UniversalScientificTechnologies/MRAKOMER3/mrakomer3_Small.jpg

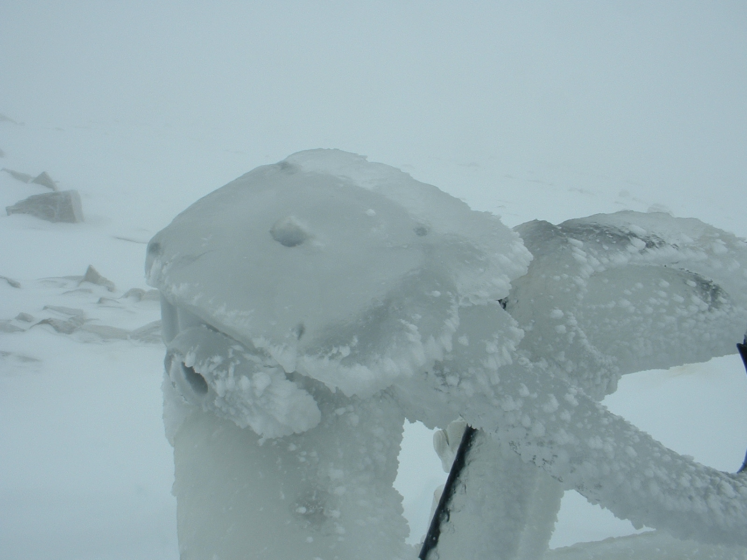
mrakomer3_Small.jpg
