UniversalScientificTechnologies/MRAKOMER3/PrjInfo.txt

//
// This is a project description file.
//

[InfoShortDescription.en]
Mrakomer3 (Clouds sensor) 

[InfoShortDescription.cs]
Mrakoměr3
  
[InfoLongDescription.en]
New design of the Cloudsmeter. This is a device for measurement the clouds coverage. This device is especially constructed for protection of robotics telescopes against rain and snow.

[InfoLongDescription.cs]
Přístroj pro detekci oblačnosti. Byl navržen pro detekci možnosti srážek jako součást robotických dalekohledů. Tento model je první generací bez pohyblivých částí.

[End]
