UniversalScientificTechnologies/MRAKOMER3/DOC/src/P1010130.JPG

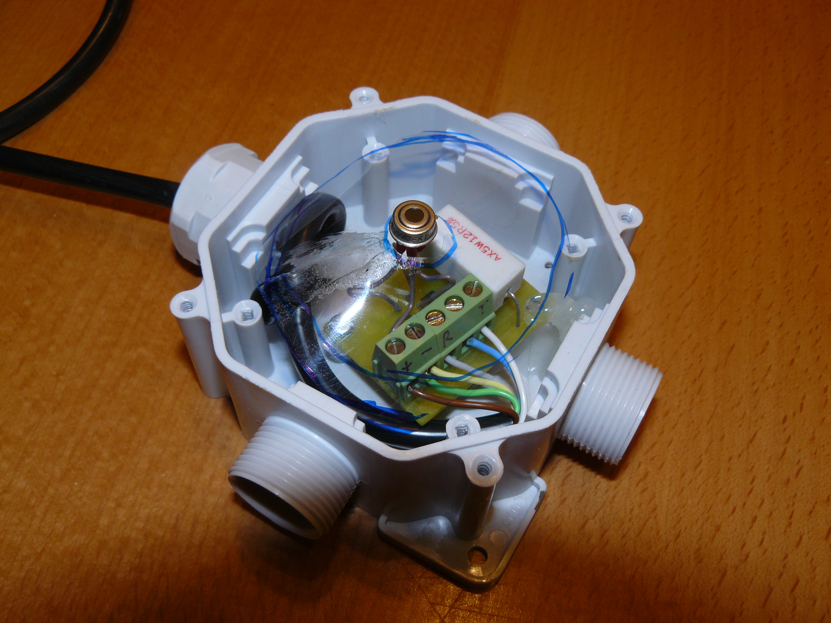
DOC/src/P1010130.JPG
