UniversalScientificTechnologies/MRAKOMER3/DOC/src/P1010132.JPG

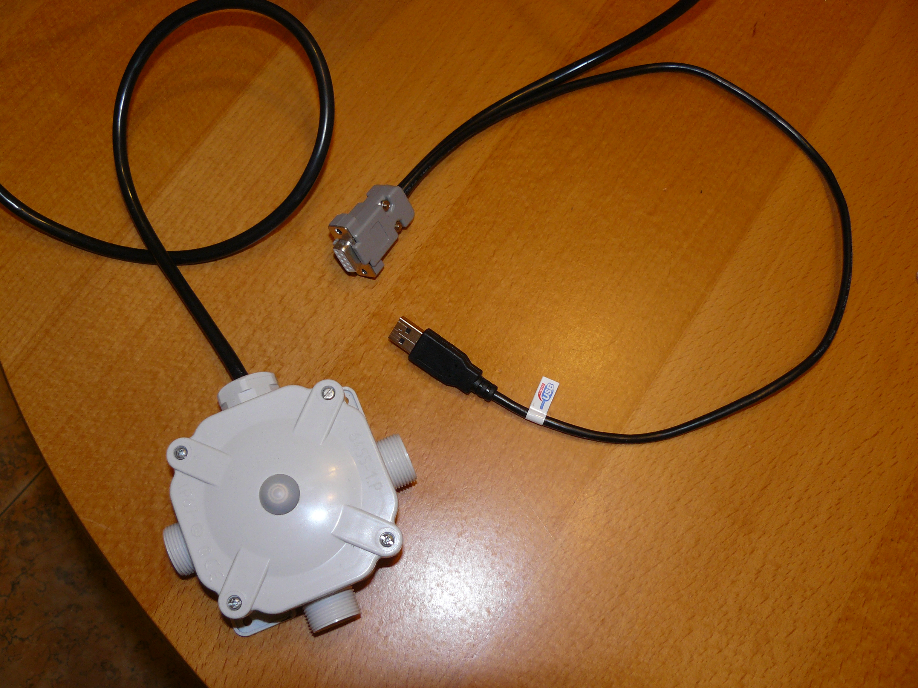
DOC/src/P1010132.JPG
