UniversalScientificTechnologies/MRAKOMER3/CAM/souhrn.pdf

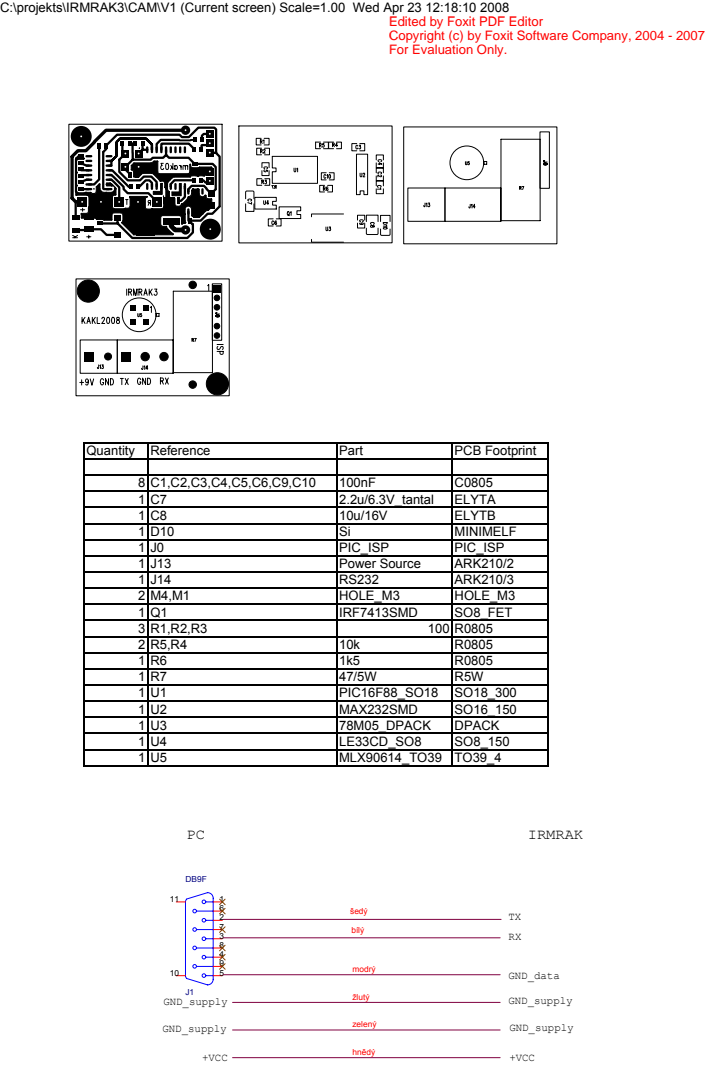
[picture p5: page 1]

C:\projekts\IRMRAK3\CAM\V1 (Current screen) Scale=1.00 Wed Apr 23 12:18:10 2008

Edited by Foxit PDF Editor
Copyright (c) by Foxit Software Company, 2004 - 2007
For Evaluation Only.

8 | C1,C2,C3,C4,C5,C6,C9,C10 | 100nF | C0805
1 | C7 | 2.2u/6.3V_tantal | ELYTA
1 | C8 | 10u/16V | ELYTB
1 | D10 | Si | MINIMELF
1 | J0 | PIC_ISP | PIC_ISP
1 | J13 | Power Source | ARK210/2
1 | J14 | RS232 | ARK210/3
2 | M4,M1 | HOLE_M3 | HOLE_M3
1 | Q1 | IRF7413SMD | SO8_FET
3 | R1,R2,R3 | 100 | R0805
2 | R5,R4 | 10k | R0805
1 | R6 | 1k5 | R0805
1 | R7 | 47/5W | R5W
1 | U1 | PIC16F88_SO18 | SO18_300
1 | U2 | MAX232SMD | SO16_150
1 | U3 | 78M05_DPACK | DPACK
1 | U4 | LE33CD_SO8 | SO8_150
1 | U5 | MLX90614_TO39 | TO39_4
