UniversalScientificTechnologies/MRAKOMER3/CAM/O1.pdf

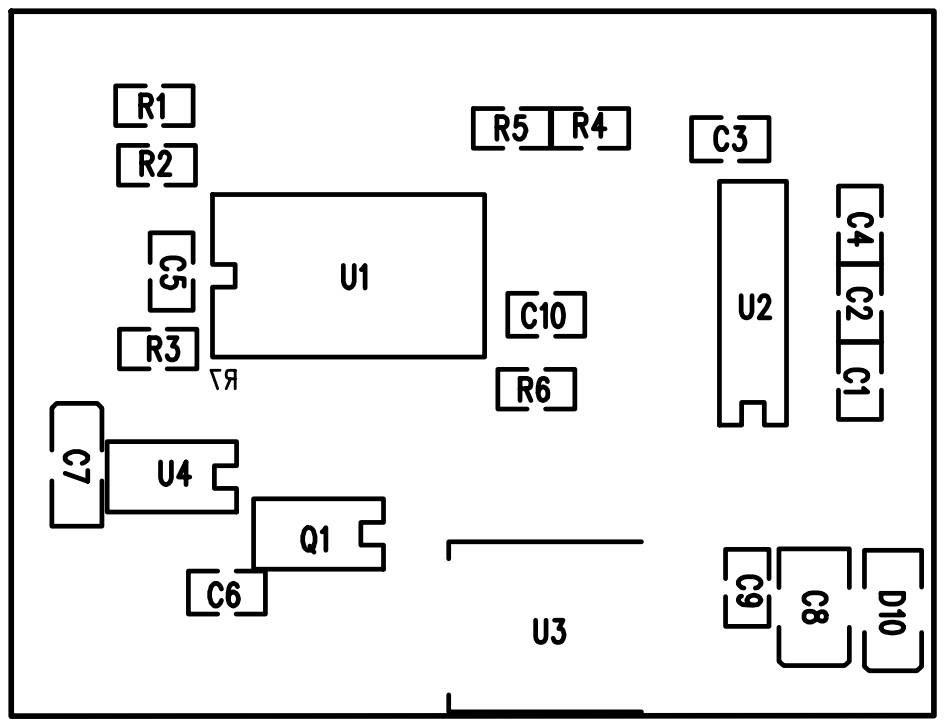
[picture p6: page 1]
