UniversalScientificTechnologies/MRAKOMER3/CAM/T2.pdf

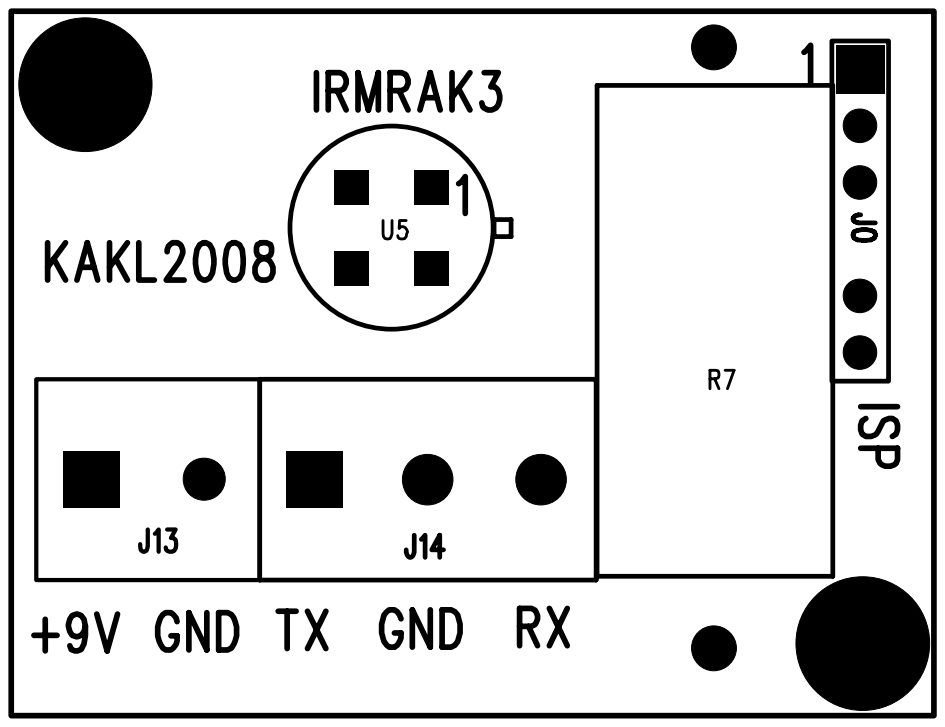
[picture p7: page 1]
