UniversalScientificTechnologies/MRAKOMER3/CAM/T2_5V.pdf

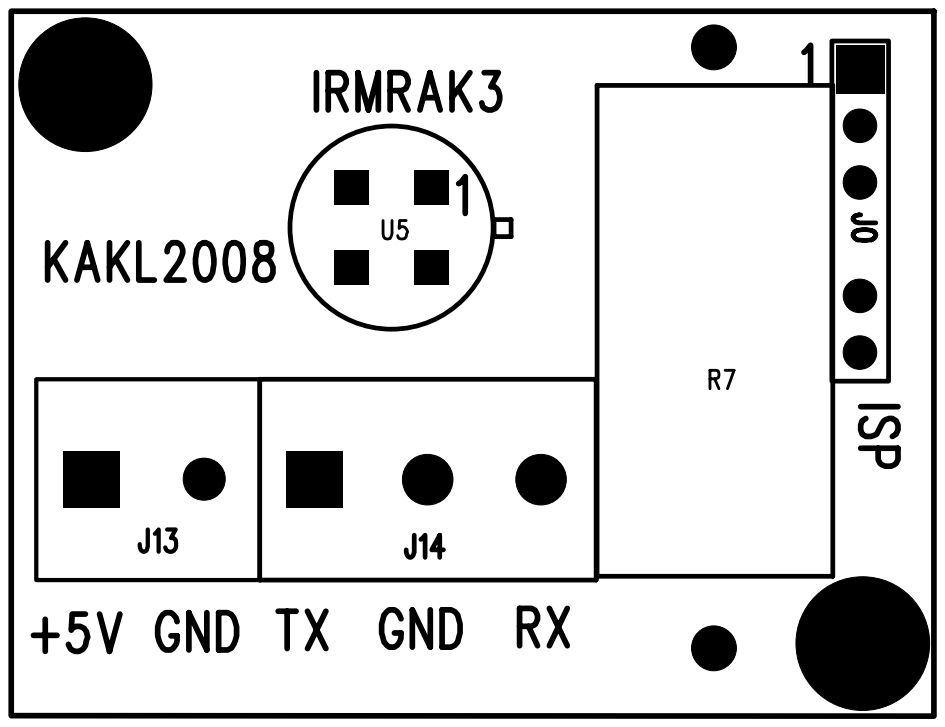
[picture p8: page 1]
