UniversalScientificTechnologies/MRAKOMER3/SCH/IRMRAK3.pdf

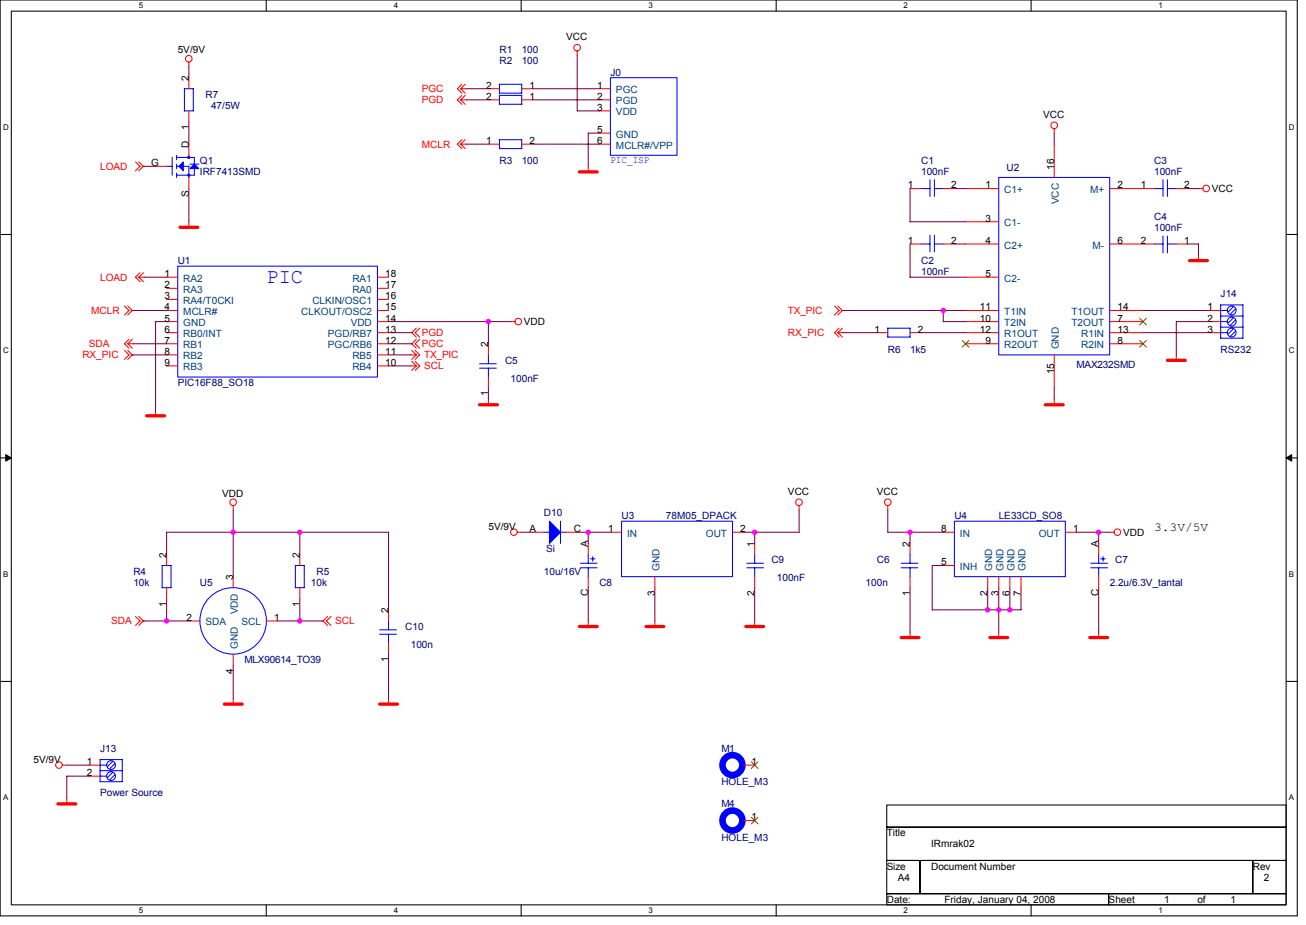
[picture p9: page 1]

Size A4 | Document Number | Rev 2

Date: Friday, January 04, 2008 | Sheet 1 of 1
