UniversalScientificTechnologies/MRAKOMER3/(list of files, drawings)

Other design files:
PCB/IRMRAK.pcb
SCH/IRMRAK.DSN
