UniversalScientificTechnologies/MRAKOMER3/DOC/baud_test/SW/GRAF_baud_test.xls

Teplota | BAUD | err
-31 | 2391.4 | 0.3583333333
-31 | 2388.35 | 0.4854166667
-31 | 2390.8 | 0.3833333333
-31 | 2391.13 | 0.3695833333
-31 | 2391.05 | 0.3729166667
-31 | 2388.49 | 0.4795833333
-31 | 2389.87 | 0.4220833333
-31 | 2389.44 | 0.44
-31 | 2388.81 | 0.46625
-31 | 2388.67 | 0.4720833333
-31 | 2389.99 | 0.4170833333
-31 | 2389.55 | 0.4354166667
-31 | 2390.67 | 0.38875
-31 | 2388.82 | 0.4658333333
-31 | 2390.46 | 0.3975
-31 | 2390.56 | 0.3933333333
-28 | 2389.49 | 0.4379166667
-23 | 2390.79 | 0.38375
-18 | 2390.8 | 0.3833333333
-15 | 2390.34 | 0.4025
-10 | 2390.36 | 0.4016666667
-6 | 2392.47 | 0.31375
-3 | 2391.85 | 0.3395833333
-1 | 2392.09 | 0.3295833333
2 | 2391.86 | 0.3391666667
4 | 2390.94 | 0.3775
6 | 2390.88 | 0.38
8 | 2391.23 | 0.3654166667
10 | 2390 | 0.4166666667
11 | 2390.34 | 0.4025
12 | 2389.18 | 0.4508333333
13 | 2389.13 | 0.4529166667
14 | 2388.82 | 0.4658333333
15 | 2388.82 | 0.4658333333
16 | 2388.38 | 0.4841666667
16 | 2388 | 0.5
17 | 2387.93 | 0.5029166667
18 | 2388.21 | 0.49125
18 | 2387.79 | 0.50875
19 | 2387.67 | 0.51375
20 | 2386.82 | 0.5491666667
20 | 2387.2 | 0.5333333333
21 | 2387 | 0.5416666667
22 | 2387.26 | 0.5308333333
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
