UniversalScientificTechnologies/MRAKOMER3/DOC/FAQ.pdf

Q: What does it Mrakoměr mean?
A: The Mrakoměr is compilation of two Czech words Cloud and Measure => Clouds Meter. Right pronunciation is [mrakomjer].

Q: What is Mrakoměr good for?
A: Mrakoměr was developed for protection of telescopes against rain and snow. Signal from Mrakoměr can initiate close of a telescope dome before rain or snow.

Q:
