UniversalScientificTechnologies/MRAKOMER3/SW/irmrak3.h

#include <16F88.h>
#device adc=8

#FUSES WDT                 	//Watch Dog Timer
#FUSES INTRC_IO              	//Internal RC Osc, no CLKOUT
#FUSES PUT                 	//Power Up Timer
#FUSES NOMCLR                	//Master Clear pin used for I/O
#FUSES NOBROWNOUT            	//No brownout reset
#FUSES NOLVP                 	//No low voltage prgming, B3(PIC16) or B5(PIC18) used for I/O
#FUSES NOCPD                 	//No EE protection
#FUSES NOWRT                 	//Program memory not write protected
#FUSES NODEBUG               	//No Debug mode for ICD
#FUSES NOPROTECT             	//Code not protected from reading
#FUSES NOFCMEN               	//Fail-safe clock monitor disabled
#FUSES NOIESO                	//Internal External Switch Over mode disabled

#use delay(clock=4000000)
#use rs232(baud=2400,parity=N,xmit=PIN_B5,rcv=PIN_B2,bits=8)//,FORCE_SW)
#use i2c(MASTER,SLOW,sda=PIN_B1,scl=PIN_B4,SMBUS)
