UniversalScientificTechnologies/MRAKOMER3/(commit log)

2007-12-07 nova verze nepohybliveho mrakomeru.
    [IRMRAK.DSN, IRMRAK.pcb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]
2007-12-08 opraveny chyby v mrakomeru3
    [IRMRAK.DSN, IRMRAK.pcb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]
2007-12-09 Dokončena dokumentace od modulu NFET2X01A - dvojice N-FET tranzistorů
2007-12-24 16F88 ma jenom HW I2C Slave. Nema HW Master.
2008-01-04 oprava schematu a PCB
    [IRMRAK.DSN, IRMRAK.pcb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]
2008-01-30 oprava PCB
2008-02-14 Doplneny obrazky k modulum v sekci PowerSupply.
2008-02-17 Zalozeny novemoduly: Zigbee a nova verze LEDbar.
2008-02-17 plosnak ledbar02A
2008-02-26 Driver k Mrakomeru3
2008-03-06 testovaci SW pro wireless moduly od firmy HOPE
2008-03-14 testovaci SW pro wireless moduly od firmy HOPE pro atmel
2008-03-31 AVR Library - LCD Driver (HD44870) in C
2008-04-14 dokumentace modulu OZ power
2008-04-28 oprava PCB T a R popisky
    [IRMRAK.pcb]
2008-05-15 test závisloti baud rychlosti na teplotě
    [GRAF_baud_test.xls]
2008-05-23 dokoncena nova verze PCB pro modu PIC16F87xTQ4401B.
2008-08-22 Novy modul ADprevodniku 16bit/250KHz SPI vystup.
2008-10-29 update + BOM seznam součástek
2008-12-13 pokrok v navrhu PCB
2008-12-17 uprava schema - jine piny I2C, HEAT, OPEN_DOME
2008-12-17 navrh PCB
2008-12-17 navrh PCB CAM_PROFI
2008-12-20 pokrok v navrhu PCB pro USBIO.
2008-12-22 Dokoncen navrh plosneho spoje RFdetect01A/PCB/RFDETECT.pcb
2009-01-07 Prepsan SMB na SW realizaci. Jednak to odpovida vic cpecifikaci nez interni I2C fce a potom se da po dobu obsluhy SMB cvicit dratem na otevirani kopule.
2009-01-08 Zmenen preklad na Case Sensitive.
2009-01-18 H-Bridge s obvodem MPC17529 (max 8V a 0.7A) - zatím jen schéma
2009-01-27 Rozpracovaný návrh PCB
2009-02-15 Dokončena dokumentace ATprogISPUSB01A a synchronizace schematu a PCB a nové technologické výstupy
2009-03-26 uprava PCB a profi vystupu
2009-04-05 IBP (info battery pack)
2009-10-08 reflow - regulace teploty v minitroubě pro pájení SMD součástek na PCB
2009-11-12 Zmenil jsem definici materialu tistaku a oznacil jsem vylejvanou med jako GND.
2010-01-02 Dalsi kus kodu k novym stopkam, vypada to, ze Interrupt od RB chodi i kdyz nema.
2010-01-13 Nový PowerSW modul pro triac SHARP S202S02
2010-01-31 BOM od programatoru
2010-02-15 funguje mereni casu v jednotkach timeru0 je treba dodelat prevod do rozummnych jednotek.
2010-02-23 návrh PCB mija
2010-02-23 návrh PCB
2010-02-23 přidané díry pro smd LED
2010-02-26 v PCB posunut konekor, aby se tam vešla krytka, zamaskovány 3mm montážní díry na straně svorkovnice
2010-03-01 uprava led na smd led
2010-03-02 návrh PCB/TRIACSHARP02A.pcb, přidány 3mm LED a změněna svorkovnice
2010-03-03 uprava vrtání pro vývody LED na 0,75mm a pro svorkovnici na 1,3mm
2010-05-12 opraveni velikosti der pro krystal.
2010-05-19 úprava PCB a schematu OZDUAL02A
2010-06-13 pridani zapomenutych der a fidu znacek
2010-06-13 Temer konecna verze PCB pro Si570. Respektive Si5XX
2010-06-27 zacatek navrhu PCB
2010-08-21 Oba PCB jsou ted navzajem zrcadlove. (neni jasne jak nejlepe ma vypadat symetrie.)
2010-09-03 pridany terminacni odpory. zbyva doresit rozvod GND
2010-10-05 modul ARM pro STM32F10xRxT
2010-11-02 uprava zaliti GND. PIC stale v rohu.
2010-12-05 vygenerovani vystupu pro vyrobu PCB.
2010-12-06 uprava modulu ARM
2010-12-22 meziverze se synchronizaci schematu a PCB.
2010-12-23 Uprava PCB
2010-12-24 opravy PCB
2011-01-04 dokonceni uprav PCB pro vyrobu.
2011-01-11 zakladni verze PCB
2011-01-12 Zalozena nоvá třída modulů pro převod signálových úrovní.
2011-01-19 Created FPGA module (school board) for XILINX Spartan 3 XC3S50AN gate array S3AN01A
2011-01-20 zacatek navrhu PCB.
2011-02-02 vygenerovani seznamu materialu
2011-02-07 vygenerovan seznam materialu
2011-02-16 navrh PCB pro ethernet.
2011-02-16 pokracovani v navrhu PCB pro ethernet.
2011-02-17 Dokončena hlavní část návrhu PCB.
2011-02-24 Pridano prepnuti PWM vystupu na B3.
2011-03-07 zacatek kresleni PCB
2011-03-17 S3AN01A opravy schématu (doplnění Errata) a přenesení změn do PCB.
2011-04-12 Aktualizovaný seznam součástek a cenový přehled (nutno doplnit reálnou cenu PCB z faktury).
2011-04-26 Jak postavir z MLABu Arduino.
2011-04-29 Do navodu pridan Wiring.
2011-05-20 Muj navrh drzaku na PCB svetelneho cidla.
2011-05-27 ISL29020 - uprava pcb pro luxmetr
2011-06-20 Seznam materialu pro Standu.
2011-06-20 vytvoreni slozky pro klon wiringu.
2011-06-22 RS232_bootloader - rs232 bootloader pro STM32F
2011-06-22 Davka pro paleni STM32R107
2011-06-24 Trochu jsem spomalil blikani LED.
2011-08-04 S PWM.
2011-08-05 Update seznamu materialu.
2011-08-14 Fluxgate magnetometer import
2011-09-03 presunuti modulu PWMLED01A do lepsi slozky
2011-09-16 synchronizace skutecnych velikosti der.
2011-09-18 uprava velikosti der
2011-09-23 lepsi rozmisteni soucastek pro pwmled
2011-09-26 pripraven priklad pro wiring.
2011-10-14 vylepseno blikani ledkou
2011-12-06 plosnak pwm driver
2012-01-04 upravena izolacni vzdalenost z 5 milsu na 6 milsu (0,152mm)
2012-02-02 Pridan obrazek k magnetometrum.
2012-02-02 Popis testovaciho zapojeni s magnetometrem MAG3110.
2012-02-06 pridani katalogoveho listu k IMU jednotce.
2012-02-06 pridani navrhu PCB sparkfun breakout bordu.
2012-02-08 pridani obrazku Wiringu.
2012-05-08 opraveni chybi v oznaceni I2C pinu
2012-06-01 vygenerovano schema nezizesilovace pro pripojeni SDRX01B k ADC
2012-06-03 zalozen modul pro driver laserove diody.
2012-06-03 rozkreslene schema driveru.
2012-06-04 prvni nahled PCB.
2012-06-04 prvni zaroutovany plosny spoj laseroveho driveru.
2012-06-04 pridan univerzani pad pro laserovou diodu.
2012-06-04 import univerzalniho pouzdra LD diody do PCB.
2012-08-04 Opravena spatna velikost pouzdra u laseru. v dusledku toho se nevejde vyvod na monotorovaci diodu.
2012-08-05 vycentrovani laseroveho modulu.
